MaazM1/rfr27-newmember-10/docs/main.pdf

# RFR27 16-Channel Temperature Monitor New Member Project-10

## Rutgers Formula Racing

Maaz Mansuri, Joshua Scallo, Fayella Fenton, Gavin Palacios November 10, 2026

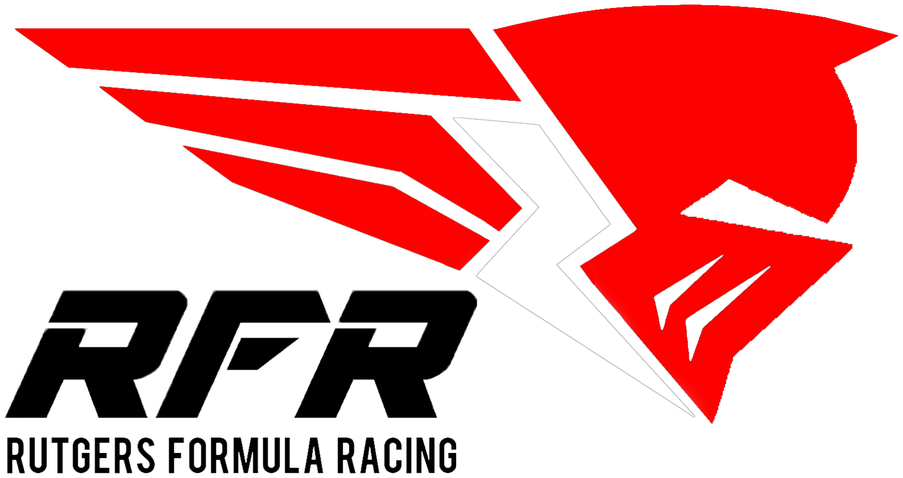
[picture p4: figure]

Maaz Mansuri, Fayella Fenton, Joshua Scallo, Gavin Palacios
RFR27 new member-10 | 1

## Contents

1 Revision Log | 2
2 Purpose | 2
3 Parties Involved | 2
4 Hardware Design | 3
5 Firmware Design | 7
6 Bill of Materials | 11
7 Sources | 12

## 1 Revision Log

Editor | Date | Revision
Maaz Mansuri | Oct. 12 2026 | Document Creation
Maaz Mansuri | Oct. 15 2026 | Established outline of documentation and table of contents
Fayella Fenton | Oct. 15 2026 | Inserted Source Refs
Joshua Scallo | Oct. 17 2026 | Added schematic and hardware descriptions
Maaz Mansuri | Oct. 19 2026 | Completed firmware Design and added flowcharts for the circuit and the code
Joshua Scallo | Nov. 4 2026 | Updated schematic version and completed schematic design justifications.
Joshua Scallo | Nov. 9 2026 | Added complete BOM
Maaz Mansuri | Nov. 10 2026 | Updated code and revised explanations for firmware design

## 2 Purpose

Create a 16-channel temperature monitor for the accumulator container and transmit pack thermal data over the I2C bus upon master query.

## 3 Parties Involved

Name | Team Role | Report Role
Maaz Mansuri | Software | Author
Joshua Scallo | Hardware | Author
Fayella Fenton | Hardware | Author
Vaanika Singla | Electronics Lead | Reviewer
Jeevan Shah | Electronics Lead | Reviewer

## 4 Hardware Design

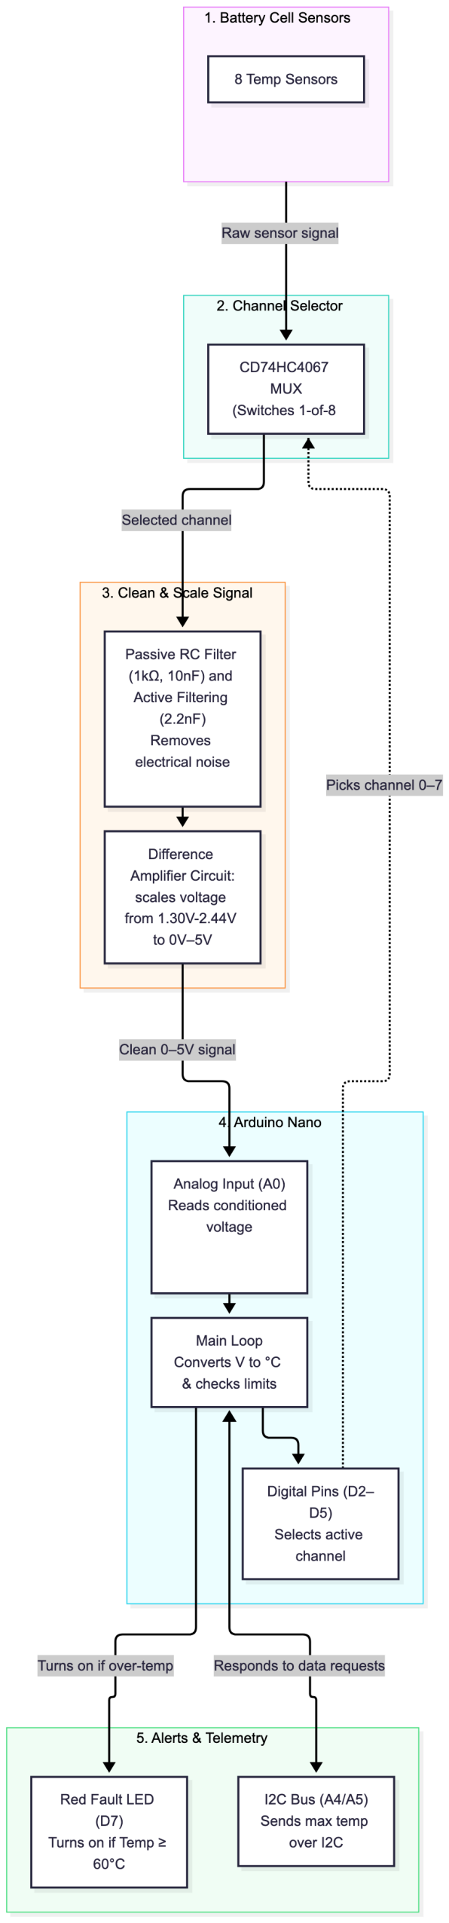
[picture p5: figure]

Figure 1: Hardware System Signal-Flow and Architecture Diagram

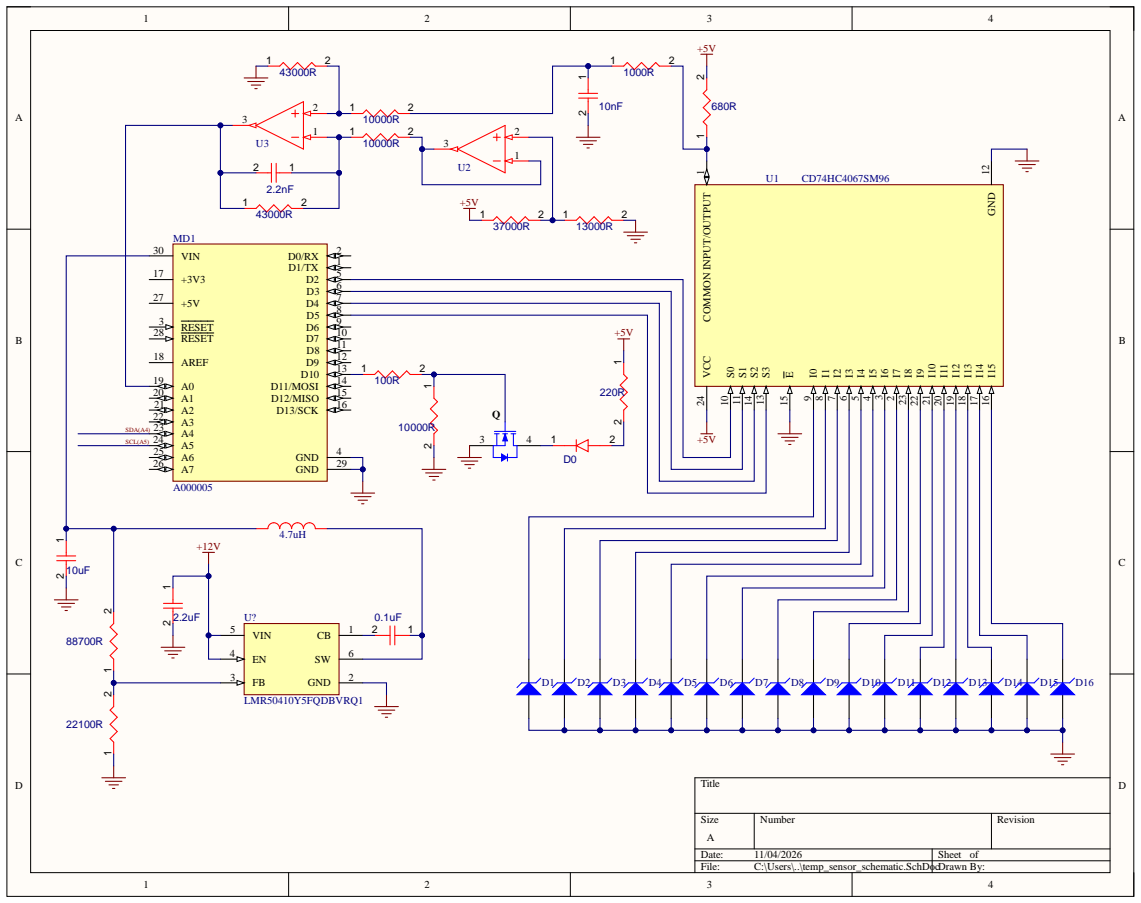
[picture p6: figure]
Title; Size; Number; Revision; Date:; Sheet of; File:; C:\Users\..\temp_sensor_schematic.SchDocDrawn By:; VIN 30; D11/MOSI; D12/MISO; D13/SCK; GND; RESET 3 RESET 28; AREF 18; VCC 24; N INPUT/O; UTPUT 1; SDA(A4); SCL(A5); VIN 5; LMR50410Y5FQDBVRQ1 ² 1

Figure 2: Schematic

### 4.1 Introduction to Schematic Design

Our schematic design contains 16 temperature sensors represented by zener diodes, a 16-channel multiplexer (CD74HC4067SM96), signal conditioning circuitry, an Arduino Nano, and a buck converter (LMR50410Y5FQDBVRQ1). This design allows the use of the Arduino Nano’s onboard ADC to collect the voltage readings from each temperature sensor one by one with help from the 16-channel multiplexer. This is achieved by connecting
each channel of the multiplexer to a temperature sensor reading. These channels are then controlled by the
firmware in the Arduino Nano’s D2-D5 pins, where each chosen output of the multiplexer is first conditioned, then sent to the A0 pin of the Arduino Nano, where the voltage is gathered and tested through the firmware. The MOSFET-controlled LED connected to the D10 pin then shines when the voltage reading interprets a temperature reading higher than 60 C.

### 4.2 RC Filter

- RC filter’s main intention is to smooth out the sharp changes from the MUX switching between channels.
- 1 kΩ resistor will act as a current limiter. The resistor value cannot be too high, or it will affect the difference amplifier’s 10 kΩ resistance value and mess with its overall gain.
- 10 nF capacitor is chosen due to time constant (τ ).

Cutoff Frequency:

fc =

1
2πRC ≈ 15.9 kHz

### 4.3 Difference Amplifier

Temperature Sensor Voltage-Temperature Outputs:

Temperature: | −40◦C | −→ 60◦C −→ | 120◦C
Output Voltage: | 2.44 V | −→ 1.81 V −→ | 1.30 V
| (min temp) | (target temp) | (max temp)

Difference Amplifier Circuit Analysis:
Intended to create a 0 V − 5 V output range from the temperature sensor readings (1.30 V − 2.44 V). Transfer Function:
VO =

R2
R1

(VMUX − VREF)

(︃
| | where R2
| | R1

is gain A

)︃

5 = A(2.44 − 1.3) =⇒ A =

5 V
1.14 V

≈ 4.386

Using standard resistor values: R1 = 10 kΩ and R2 = 43 kΩ
43 kΩ
10 kΩ

= 4.3 =⇒ A = 4.3 (ideal gain is truncated down to avoid clipping above 5 V)

### 4.4 Voltage Divider & Buffer Op-Amp

Voltage Divider Calculation:
We want VREF = 1.3 V:

5

(︃
R2
R1 + R2

)︃
= 1.3 V

Using standard resistor values: R2 = 13 kΩ and R1 = 37 kΩ

Buffer Op-Amp Analysis:

- Buffer op-amp will prevent voltage loading.
- Internal Thevenin resistance from R1 & R2 of the voltage divider will affect the R1/R2 ratio of the difference amplifier.
- Buffering will create a clone 1.3 V (provided by 5 V) that is clean like a 1.3 V battery.

### 4.5 Active Filtering (2.2 nF Capacitor)

gain(f) = Rf

Rin

ZF =

Rf
1 + j2πfRfCF

with CF = 2.2 nF

f0 =

1
2πRfCF

≈ 1.682 kHz

Zf = 0 Ω @ f = 0 Hz

Zf = 43 kΩ @ f ≈ 1.68 kHz

- This means higher frequencies will short-circuit Rf , which will make the gain equal zero.
- This allows higher frequencies to be eliminated.

### 4.6 Settling Time Analysis

Settling time exists due to the time it takes for the filter’s capacitors to charge/discharge every time the multiplexer switches channels.
Capacitor follows an exponential charging curve:

V (t) = VS

(︂
1 − e

−t/τ)︂
(τ is time constant)

For an accurate reading from the 10-bit ADC on the Arduino, we need to consider the ADC resolution:

1
2

10 = 0.000977 = 0.0977%

To prevent sensor voltage reading overlap (crosstalk), the filter has to settle within 0.0977% of its final value. We need to find how many time constants are needed to reduce the error below 1
2

10 :

e

−t/τ =

1
2

10 =⇒ ln (︂
e

t/τ)︂
= ln (︁
2

10)︁

t
τ

= 10 ln(2) ≈ 6.93 =⇒ t ≈ 6.93τ

To prevent errors, round up: t = 7τ .

Hardware Settling Breakdown

- RC Filter:
7τ1 = 7(1 kΩ × 10 nF) = 70 µs
- Active Feedback:
7τ2 = 7(43 kΩ × 2.2 nF) = 662.2 µs
- Total Hardware Settling Time:

70 µs + 662.2 µs = 732.2 µs

### 4.7 Verifying 1000Hz Sampling Rate

- 1000 Hz sampling rate means it takes 1000 samples per second across all channels (1 ms per channel).
- Selecting MUX switch takes 1 µs (based off datasheet).
- Executing ADC conversion takes 112 µs (ranges from 100 µs − 125 µs).
- With our total hardware settling time being 732.2 µs...

ttot = 1 µs + 112 µs + 732.2 µs = 845.2 µs = 0.8452 ms < 1 ms

With a headroom of 154.8 µs, it is safe to say it will achieve 1000 Hz sampling rate.
Note that this does not include delays included in our firmware design. If we include the added delay to account for the capacitor settling delay (20µs) we still will achieve the desired sampling rate.

### 4.8 Buck Converter

To verify that our buck converter (LMR50410Y5FQDBVRQ1) will work with our design, we need to validate the overall output current, which, according to the provided datasheet, needs to be less than 1A.

Total Output Currents

- MOSFET LED:
5V − 2V
220Ω = 13.6mA

(2V is the max forward voltage drop from a Red LED)

- Temperature Sensors:
5V − 0.7V
1000Ω + 680Ω = 2.56mA
- x2 LM358 Op-Amps
2 × 150µA = 0.3mA
- Multiplexer: 0.008mA (quiescent device current)
- Arduino Nano: 50mA (CPU consumption)
- Total:
13mA + 2.56mA + 0.3mA + 0.008mA + 50mA = 65.868mA < 1A

This is well under the limit of 1A

### 4.9 Schematic Changes in Implementation

- In actual implementation, we utilize an 8-channel multiplexer (CD4051BE). This change would reduce it to only 2 select line pins (S0-S1) and 8 data input pins (I0-I7), which is reflected in our firmware design structure.
- The buck converter is also not included in our implementation; rather, the Arduino Nano is powered through a laptop USB-C connection.

## 5 Firmware Design

### 5.1 Introduction and Firmware Overview

The software is based on our planned wiring implementation and serves four main functions per the project instructions: reading each sensor’s analog signal, converting it to a voltage, determining the highest, lowest, and average temperature among the sensors, via linear interpolation, and reporting that value over I2C. While the original schematic includes a DC-DC converter and a 16:1 MUX, the converter is omitted here and an 8:1 MUX is used instead. This reduces the select pin count from four to three, while keeping the core firmware logic the same. An overview of our software from a high level is shown below in figure 3.

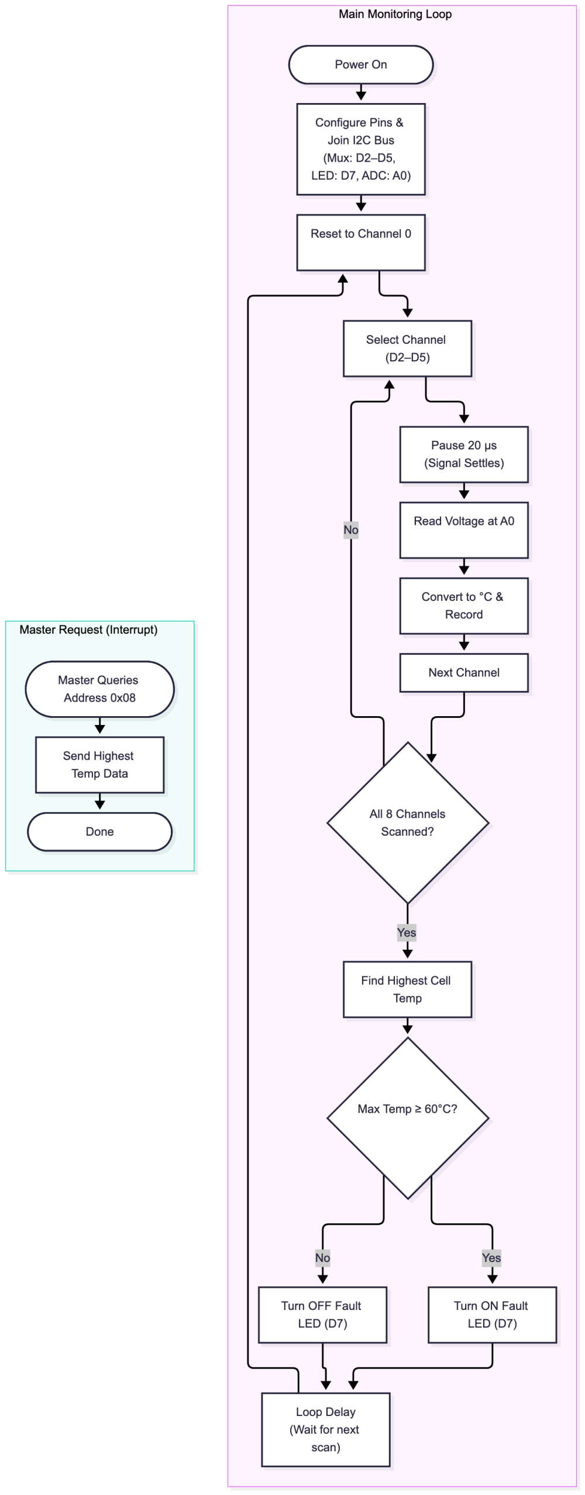
[picture p7: figure]

Figure 3: Software Flowchart

The core execution loop performs the following operations:

1. Iterates sequentially through channels 0 to 7 using the binary addresses from the select pins
2. Pauses for an explicit interval (20 µs) to discharge/charge front-end capacitance before sampling.
3. Samples the conditioned analog node via analogRead(A0) and converts the raw 10-bit count into an engineering voltage (0.0 V − 5.0 V).
4. Maps the measured voltage to temperature (◦C) based on the Enepaq sensor’s temperature and voltage mapping datasheet.
5. Evaluates cell temperatures against 60◦C critical limit, asserting the fault LED on pin D7 if overheating is detected.
6. Stores the maximum pack temperature to prepare for for I2C request

### 5.2 Pin Mapping and Peripheral Allocation

To match the schematic in Figure ??, the hardware pin configuration are mapped out as followed:

Table 1: Microcontroller Pin Allocation
Constant Name | Nano Pin | Direction | Hardware Functional Description
muxSIG | A0 | Input | Conditioned analog voltage from multiplexer
muxS0 | D2 | Output | Binary address select line: Bit 0 (2
| | | 0
)
muxS1 | D3 | Output | Binary address select line: Bit 1 (2
| | | 1
)
muxS2 | D4 | Output | Binary address select line: Bit 2 (2
| | | 2
)
muxS3 | D5 | Output | Binary address select line: Bit 3 (2
| | | 3
)
faultLED | D7 | Output | Visual Indicator for overheating
SDA | A4 | Bidirectional | I2C Data line
SCL | A5 | Input | I2C Clock line
1 | #include <Wire.h>
2 | //Defiing all of our pins here

3
4 | Signal Pin from multiplexer to the Arduino
5 | const int muxSIG = A0;

6
7 | Pins that will select what channel to read in binary
8 | const int muxS0 = 2;
9 | const int muxS1 = 3;
10 | const int muxS2 = 4;

11

12
13 | //Defining address for Arduino as Slave
14 | const byte SLAVE_ADDRESS = 0x08;

Listing 1: Pin definitions

### 5.3 Overview of functions

### 5.3.1 Channel Addressing: setMuxChannel

The 8:1 Multiplexer needs a 3 bit binary value to select the channel. Instead of manually iterating through binary, we call this function to input the desired channel we want to read as a byte, and then it will convert it to the binary equivalent using Arduino’s bit read function.

1 | void setMuxChannel(byte channel) | {
2 | //Allows you to input an integer and then it converts it into binary for the signal pins to read and select the
| channel
3 | digitalWrite(muxS0, bitRead(channel, 0));
4 | digitalWrite(muxS1, bitRead(channel, 1));
5 | digitalWrite(muxS2, bitRead(channel, 2));
6 | }
Listing 2: setMuxChannel Function

### 5.3.2 Signal Acquisition: readChannelVoltage

This function switches the channel, pauses for the signal to stabilize, takes a 10-bit analog sample, and converts the integer output to a floating point voltage using the voltagetoTemperature helper function.

1 | float readChannelVoltage(byte channel) {
2 | setMuxChannel(channel);
3 | delayMicroseconds(20);

4
5 | int rawADC = analogRead(muxSIG);
6 | return voltagetoTemperature(rawADC);
7 | }
Listing 3: readChannelVoltage Function

### 5.3.3 Mapping our voltage readings into temperature values: voltagetoTemperature

Since the ADC doesn’t give us a voltage value that’s scaled correctly, we have to rescale it from 0-5V using the following equation.

Vmeasured = ADC ×

(︃
5.0 V
1023.0

)︃
(1)

Once the value is converted, we use linear interpolation to map out the voltage from the lookup table given in the Enepaq data sheet, and convert the scaled value to the temperature.
Note: In our actual implementation we used 4.850 V as our ceiling voltage. The theoretical value of the voltage reading from the Adruino Nano is 5V, however, after testing the value with the multimeter, we find that it actually outputs 4.850 V
1 | float voltagetoTemperature(int rawADC) {
2 | //Converts rawADC value to actual voltage value between 0-5 volts
3 | //It will be between 1.30V to 2.44V based on the diode
4 | float volt = (rawADC * 4.850f) / 1024.0f;
5 | //Linear interpolation using the two datasheet coordinates
6 | // (-40 C @ 2.44V) and (120 C @ 1.30V)
7 | const float V_cold = 2.44f;
8 | const float V_hot | = 1.30f;
9 | const float T_cold = -40.0f;
10 | const float T_hot | = 120.0f;

11
12 | float slope = (T_hot - T_cold) / (V_hot - V_cold); // ~ -140.3509 C/V.
13 | //For every voltage increase there is a -140 decrease in temperature. (negative slope)
14 | float temp | = T_cold + slope * (volt - V_cold);
15 | return temp;
16 | }
Listing 4: Voltage to Temperature Conversion

Note: Our linear interpolation is very rough. We took data points from the highest and lowest temperature and found the slope creating a straight line curve to map the voltage. This is not reflective of the actual curve, and so our conversion values will be off. If given more time/AI assistance, we would create a struct and include all of the values from the look up table, then linear interpolate between neighboring points by looping through our array of temperature and voltages.

### 5.3.4 I2C Implementation: requestData

When the bus master addresses the slave node 0x08, the hardware triggers the request data function.

1 | void requestData() {
2 | //send avg, highest, and lowest temperatures over I2C
3 | Wire.write((byte*)&avgTemp, sizeof(avgTemp));
4 | Wire.write((byte*)&maxTemp, sizeof(maxTemp));
5 | Wire.write((byte*)&minTemp, sizeof(minTemp));
6 | }

Listing 5: I2C Slave Transmission Callback

### 5.4 Design Choices

### 5.4.1 Settling Delay Choice (20 µs)

- Context: Inside the multiplexer, each switch adds about 70 Ω to 180 Ω of internal resistance This sits right before our input filter stage, which uses a 1 kΩ resistor and a 10 nF capacitor before feeding the signal to the op-amp.
- Alternative Considered: Reading the ADC right after changing the channel address pins, with zero delay in between.
- Decision & Rationale: If we sample immediately, voltage left over on the capacitor from the previous channel will bleed into the new reading. The capacitor needs a moment to charge up to the new voltage level. We can find how long this takes using the circuit’s RC time constant:
τ = Rtotal × C ≈ (1000 Ω + 180 Ω) × 10 nF = 11.8 µs | (2)

Waiting 20 µs gives the signal about 1.7τ to settle down, ensuring our ADC reading reflects the true sensor voltage rather than residual charge from the channel before it. Across all 8 channels, this delay is negligible and we would not hinder our target of 1000hz sampling rate.

## 6 Bill of Materials

The following table itemizes all electronics required within our schematic. This BOM excludes some common found passive components (Through-hole resistors, capacitors, and LED diode), as well as the provided temperature sensors. All component prices and part numbers are sourced from Digikey.

Table 2: Project Bill of Materials (BOM)

Item # | Category | Vendor / SKU | Qty | Unit ($) | Total ($) | Status
A-01 | Development Boards | Arduino / A000005 | 1 | $25.70 | $25.70 | In Stock
A-02 | Voltage Regulators | Texas Instruments / 296-
| | LMR50410Y5FQDBVRQ1TR-
| | ND | 1 | $2.32 | $2.32 | In Stock
A-03 | Op Amps | Texas Instrument /
296-47593-2-ND
1 | $0.33 | $0.33 | In Stock
A-04 | Multiplexers | Texas Instruments /
296-2057-5-ND
1 | $0.94 | $0.94 | In Stock
A-05 | MOSFETs | Diotec Semiconductor /
4878-2N7000CT-ND
1 | $0.29 | $0.29 | In Stock
| | Subtotal: | $29.58
Est. Shipping: | $8.49
| | Tariff: | $0.26
Est. Total Cost: | $38.33

## 7 Sources

## References

[] Understanding Our Components

[1] Robotics Back-End, Arduino Uno - Pins Overview, YouTube, 2021. Available: https://youtu.be/bniUECtJkeU (https://youtu.be/bniUECtJkeU)
[2] Electronoobs, Arduino Multiplexor - MUX INPUTS & OUTPUTS - ANALOG and PWM, YouTube, 2021. Available: https://youtu.be/Dco6jo9xgAo
[3] Dejan, How I2C Communication Works?, HowToMechatronics. Available: https://howtomechatronics.com/tutorials/arduino/how-i2c-communication-works-and-how-to-use-it-with-arduino/ (https://howtomechatronics.com/tutorials/arduino/how-i2c-communication-works-and-how-to-use-it-with-arduino/)
[4] CircuitBread, Intro to Op-Amps (Operational Amplifiers) | Basic Circuits, YouTube, 2022. Available:
https://youtu.be/fmRHDqcodS4
[5] Temperature Sensor Datasheet. Available: https://enepaq.com/wp-content/uploads/2025/02/Sony-Murata-VTC5A-Li-ion-Battery-Module-With-Temperature-Sensor-Datasheet-.pdf (https://enepaq.com/wp-content/uploads/2025/02/Sony-Murata-VTC5A-Li-ion-Battery-Module-With-Temperature-Sensor-Datasheet-.pdf)

[] Circuit Basics

[6] RimstarOrg, How to Read a Schematic, YouTube, 2014. Available: https://youtu.be/_HZ-EQ8Hc8E
[7] EEVblog, Playlist on DC Fundamentals, YouTube, 2017. Available: https://www.youtube.com/show/VLPLZJkSyc12jDY?sbp=KgtZZGJobm1BNE05Z0AB (https://www.youtube.com/show/VLPLZJkSyc12jDY?sbp=KgtZZGJobm1BNE05Z0AB)

[] Arduino IDE
