MaazM1/rfr27-newmember-10/hardware/arduino_temp_sensor_v4.pdf

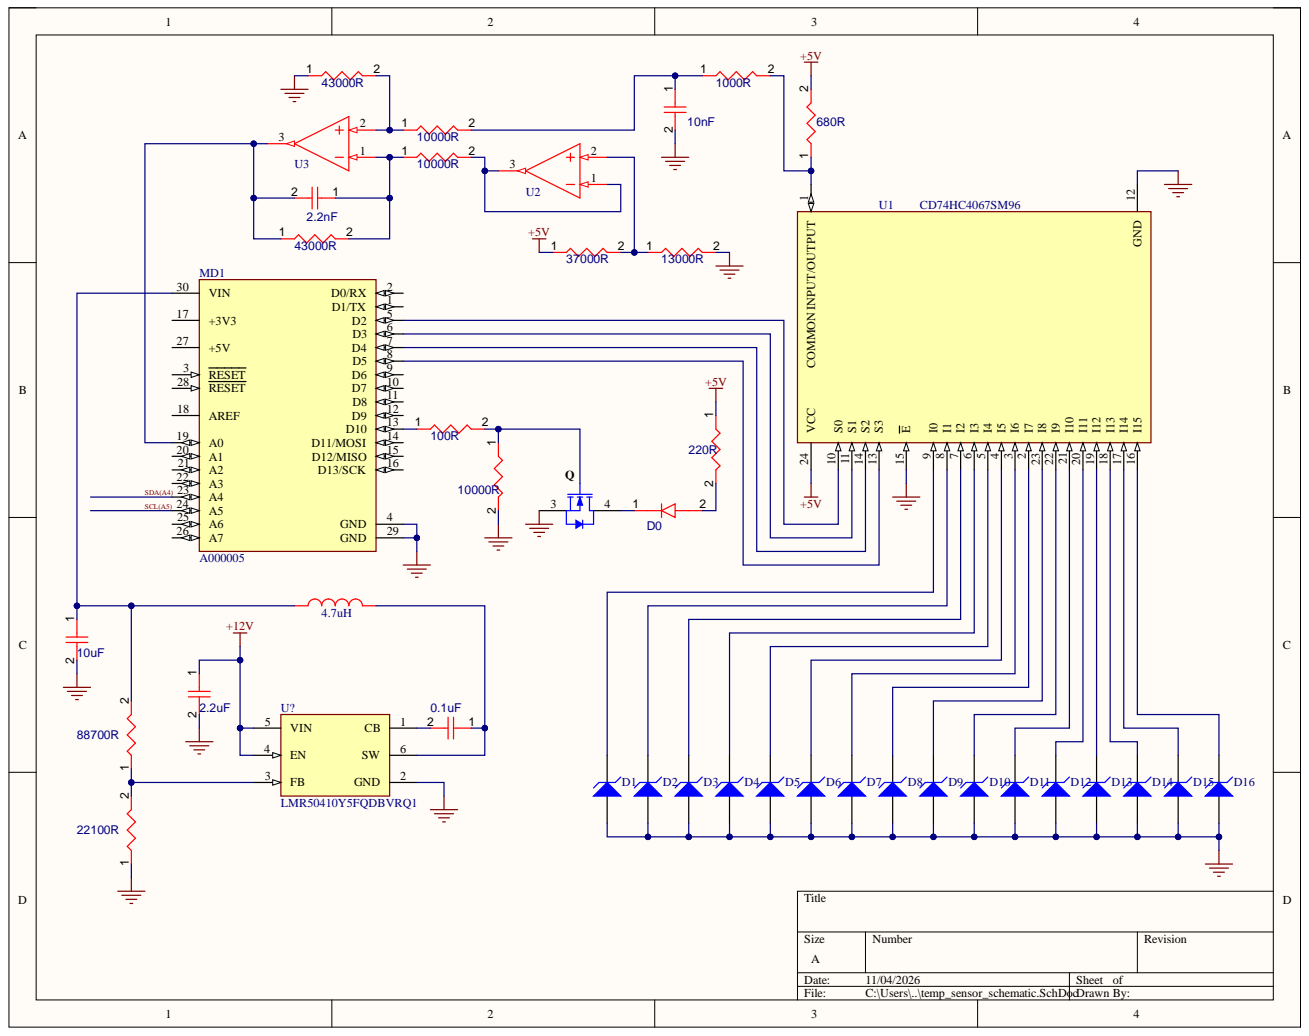
[picture p8: page 1]
