MaazM1/rfr27-newmember-10/docs/arduino_temp_sensor_v3.pdf

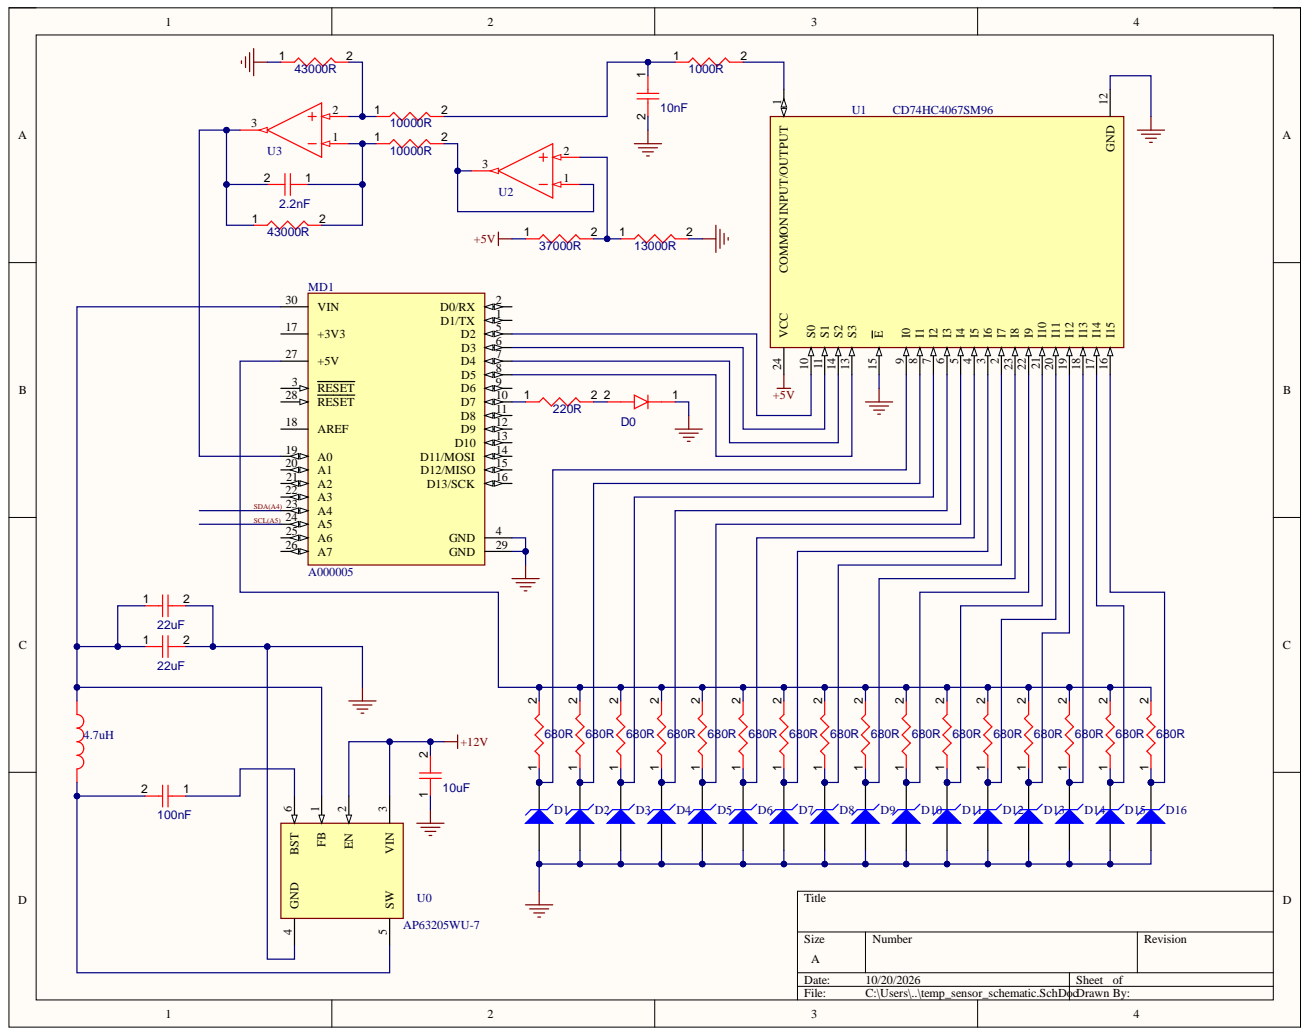
[picture p9: page 1]
