MaazM1/rfr27-newmember-10/hardware/arduino_temp_sensor_v2.pdf

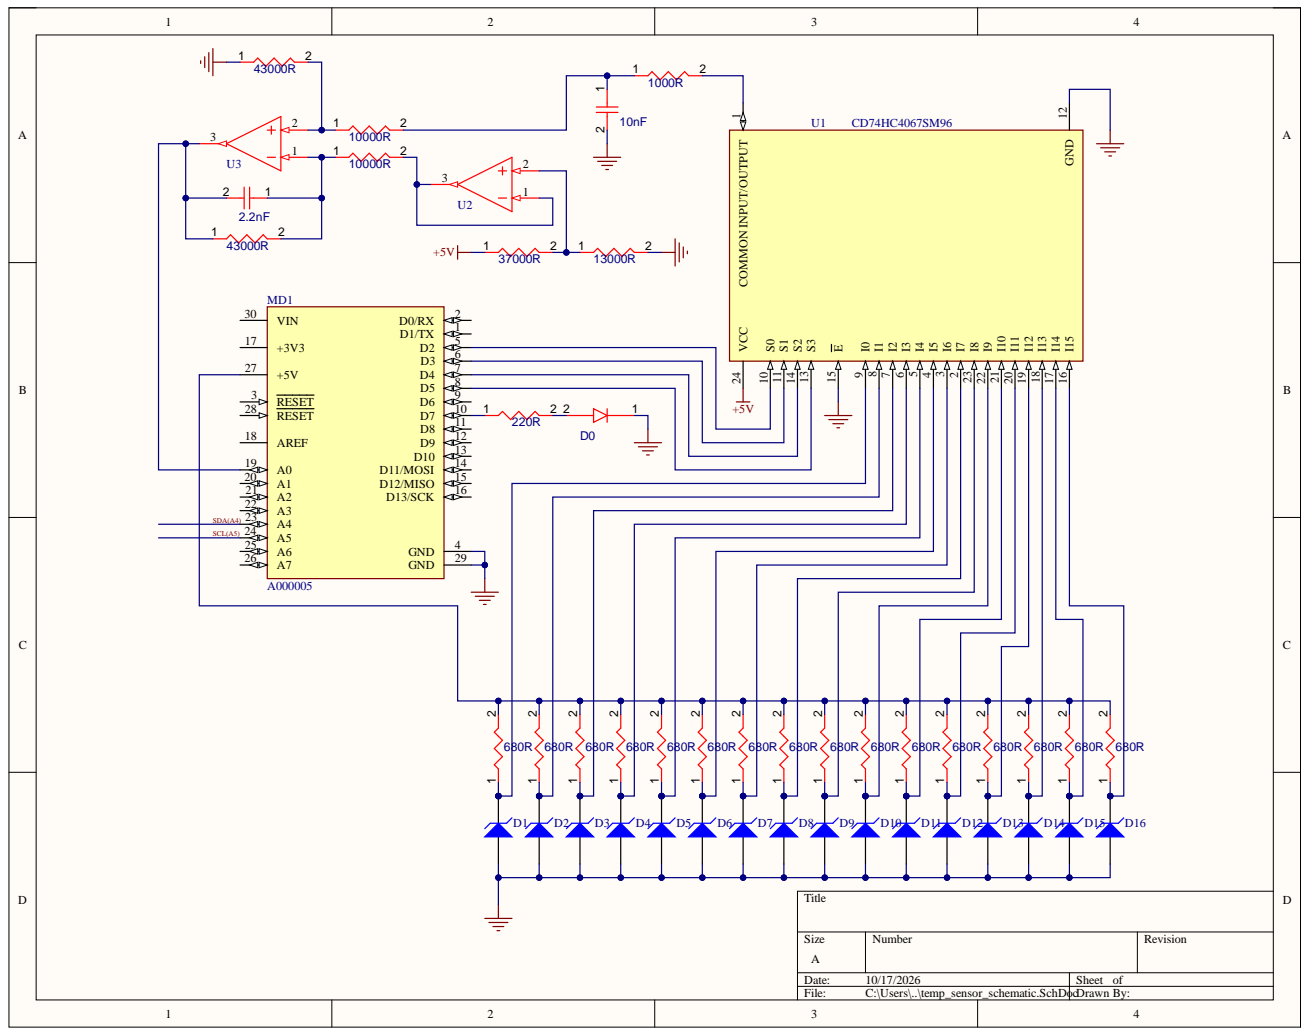
[picture p10: page 1]
