MaazM1/rfr27-newmember-10/hardware/arduino_temp_sensor.pdf

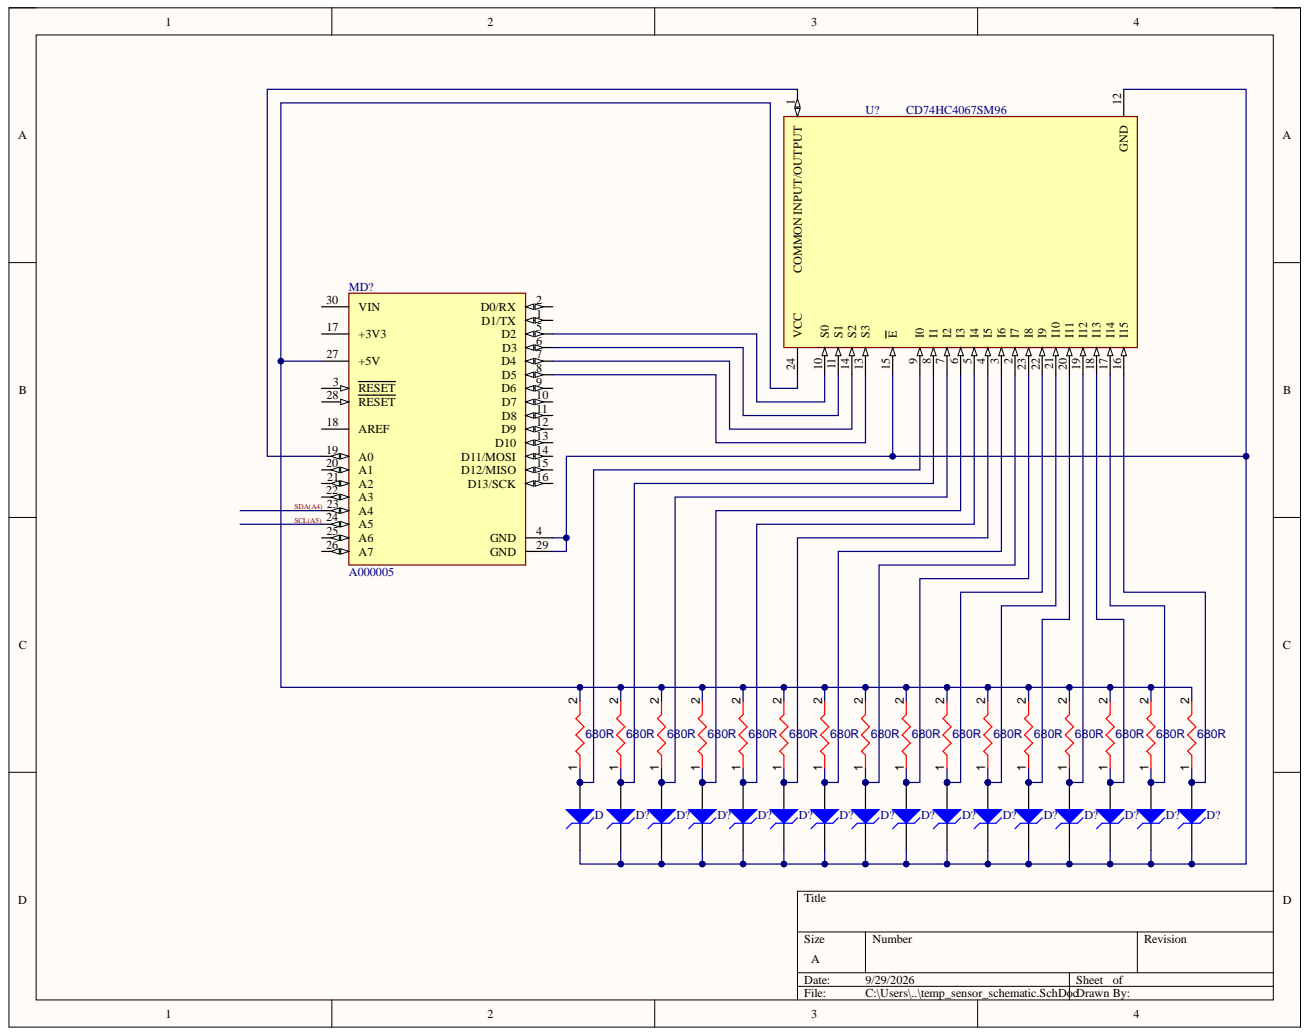
[picture p11: page 1]
