MaazM1/rfr27-newmember-10/(commit log)

2026-10-03 Add files via upload
    schematic design update #1 (10/3/26)
2026-10-10 Added Temperature Monitor code skeleton
    Partially completed skeleton code. Just setting up the multiplexor pins, and some functions to be implemented.
2026-10-15 docs: Established outline of documentation
    - Made 8 Sections
    - Revision, purpose, parties involved
    - Hardware
    -Software
    - Test results
    -BOM
    -Sources
2026-10-15 docs:fix dupe circuit basics links
2026-10-17 Add files via upload
    Added signal conditioning that goes from multiplexer to A0 pin of Arduino Nano. Also corrected orientation of zener diodes.
2026-10-17 Delete hardware/arduino_temp_sensor_v2.pdf
    wrong file
2026-10-18 Feat: added I2C implementation,
    - Set arduino as slave for I2C
    - Intialized pins,
    - Change to 3 signal pins instead of 4 to match the new 8:1 multiplexer
2026-10-20 docs: Added the flowcharts and software section
    -added the flowchart png files
2026-10-20 Add files via upload
    added 12V-5V buck converter
2026-10-20 Change figure label from v2 to v3
    updated from v2 schematic to v3 schematic
2026-10-20 docs: added new schematic and pictures
2026-10-30 feat(firmware): Implemented 8 channel looping for first test
    - Full implementation excluding I2C for looping through 8 channels
    - updated voltagetoTemperature helper function to take in the rawADC value and convert it to Celsius temp
    - Implemented blinkFaultLED function
2026-11-04 Add files via upload
    condensed to x1 680 ohm resistor. Changed buck converter and its circuitry to a more inexpensive/available option.Added n-channel MOSFET circuitry for blinking LED.
2026-11-04 Delete docs/arduino_temp_sensor_v3.pdf
    old version of schematic
2026-11-04 Joshua Scallo Revision - Nov. 4 2026
    Updated schematic version and completed schematic design justifications.
2026-11-09 Add BOM section - Joshua Scallo Nov. 9 2026
    Added tabularx packages for enhanced table formatting. Included a Bill of Materials (BOM) section with detailed component information.
2026-11-10 feat: Fully implemented I2C data transfer
    -Calculated min, max, and average temp to transmit over I2C
    - Cleaned up print statements so it prints the voltage AND temperature for each channel
    -
2026-11-10 docs: Updated flowcharts and code for design doc
    - Updated flow charts to reflect 8 channel instead of 16.
    - Revised explanations for firmware design.
    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
